Hugofurther/cabane-control/docs/Stations/Optically Isolated MOS FET 4 Channel Controller Board/s-l1600-1.webp

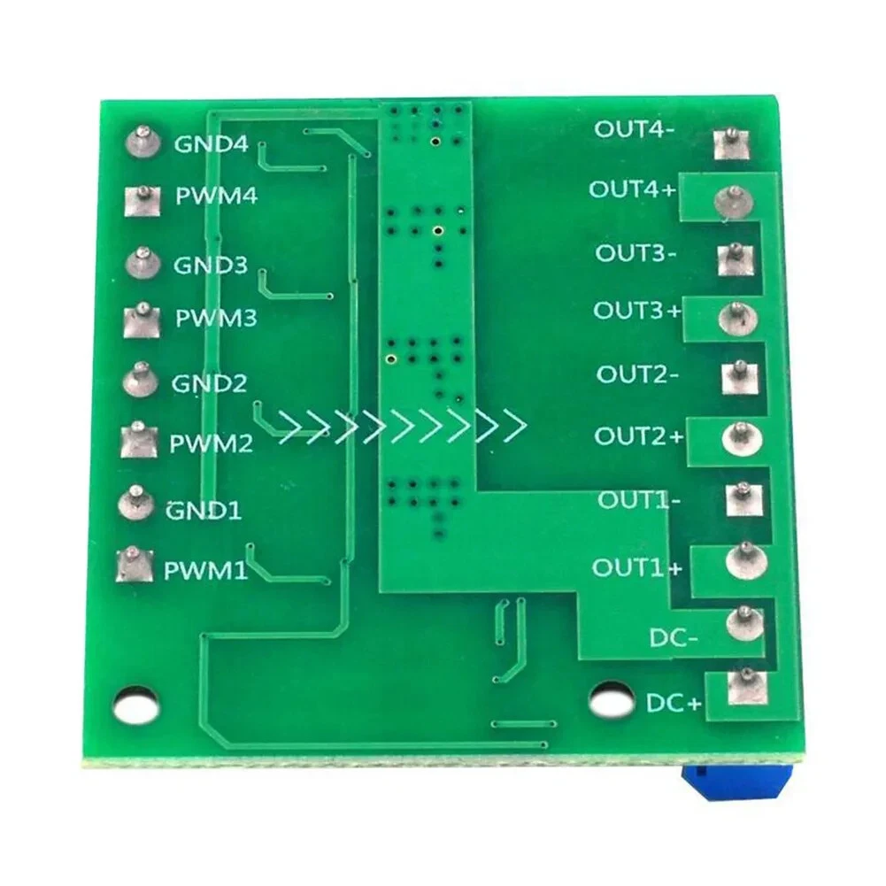
docs/Stations/Optically Isolated MOS FET 4 Channel Controller Board/s-l1600-1.webp
