Hugofurther/cabane-control/docs/Main/ELEC-MEGA2560-PINOUT.webp

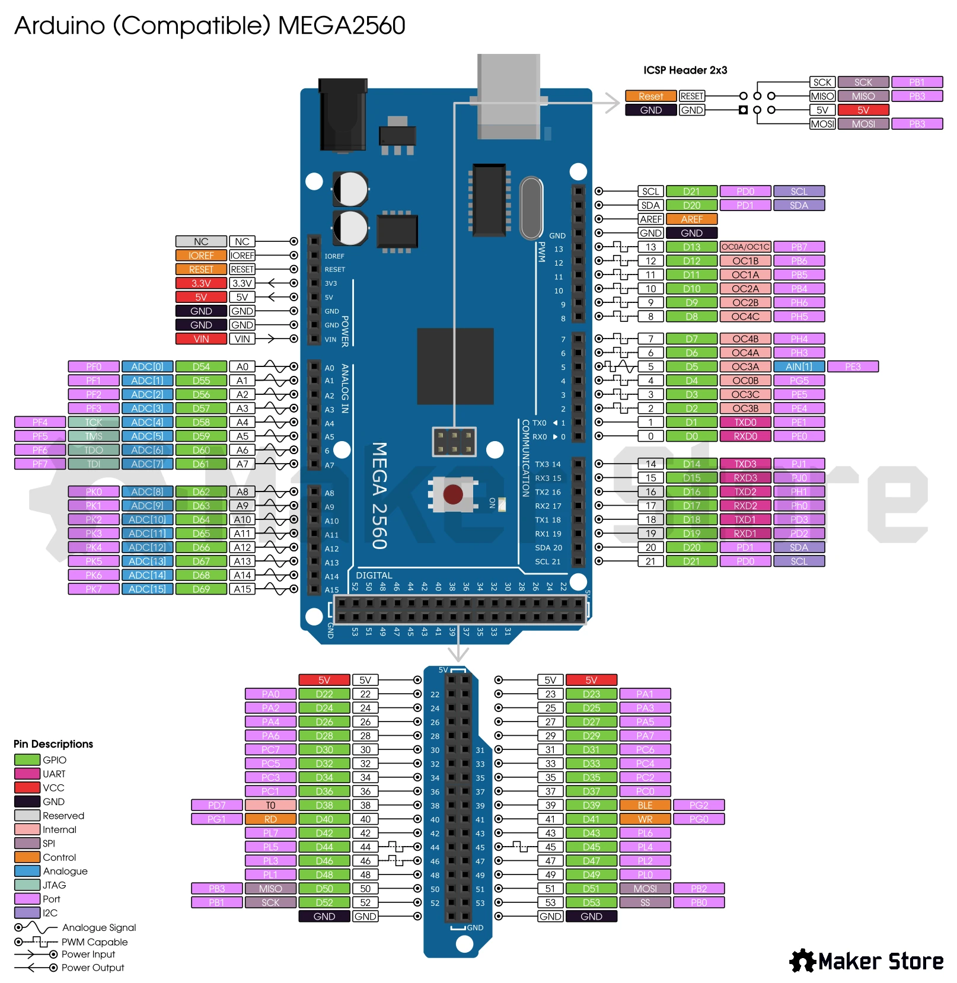
docs/Main/ELEC-MEGA2560-PINOUT.webp
