Hugofurther/cabane-control/docs/Webapp/1. The Architecture Change.md

It is **moderately difficult**, but entirely feasible. Since you already have a working UDP protocol, you have done the hardest part.

Adding a Raspberry Pi Webapp essentially turns the Pi into a "Virtual Operator" that stands next to your Main Controller and presses "Virtual Buttons."

Here is the breakdown of what it would take to implement this architecture:

### 1. The Architecture Change
Currently, your Main Controller is the **Single Source of Truth**. It reads physical pins and sends commands.
To add a Webapp, you cannot have the Pi talk directly to the Stations (this causes "Split Brain" where the Mega says OFF and the Pi says ON).

Instead, the **Pi must talk to the Main Controller**, and the Main Controller must decide which input to obey (Physical Switch vs. Web Command).

### 2. Required Changes to Main Controller (Arduino Mega)
You would need to modify your firmware to accept "Remote Commands."

*   **New Data Structure:** You need a `virtualState[TOTAL_INPUTS]` array alongside your `stableState` (physical) array.
*   **New UDP Handler:** You need to define a new packet type (e.g., `0xB1`) that the Pi sends to the Mega containing the state of the buttons on the web interface.
*   **Logic Merger:** You need to decide how the override works.
    *   *Scenario A (OR Logic):* If Physical Switch OR Web Switch is ON $\to$ Relay ON.
    *   *Scenario B (Priority Logic):* You add a "Master Auto/Manual" switch. If Manual, read physical pins. If Auto, read UDP packets from the Pi.
    *   *Scenario C (Last Latch):* Whichever source changed last (Switch flip or Web click) sets the state.
*   **Feedback Output:** The Mega needs to send a packet back to the Pi regularly (or on change) containing the status of all LEDs/Relays so the Web UI updates in real-time.

### 3. The Raspberry Pi Software Stack
The Pi acts as a bridge between HTTP (Web browser) and UDP (Arduino).

*   **Backend (Python/Node.js):**
    *   Needs a UDP Socket listener to receive status updates from the Mega.
    *   Needs a UDP Sender to fire command packets to the Mega.
    *   Needs a Web Server (Flask, FastAPI, or Express) to serve the webpage to your phone/laptop.
*   **Frontend (HTML/JavaScript):**
    *   A dashboard displaying the 24 switches and LED statuses.
    *   JavaScript to send button clicks to the Backend.
    *   JavaScript to poll the Backend for the latest status (to turn web LEDs red/green).

### 4. The Complexity & Risks
Here is where the difficulty lies:

*   **State Synchronization (The hardest part):**
    If the physical switch is ON, but you turn it OFF via the Web, what happens?
    *   Does the physical switch stop working?
    *   Does the physical LED flash to indicate a mismatch?
    *   You need robust logic to handle "Physical switch says X, Web says Y."
*   **Safety/Watchdog:**
    If you turn a pump ON via Web, and the Pi crashes or Wi-Fi dies, does the pump stay ON forever? You would need a "Network Watchdog" on the Mega to revert to physical switches if the Pi stops sending heartbeats.
*   **Latency:**
    Web $\to$ Pi $\to$ UDP $\to$ Mega $\to$ UDP $\to$ Station $\to$ Relay.
    This adds a few milliseconds of delay, which is usually fine for maple syrup, but the UI must feel responsive.

### Summary
*   **Hardware:** Easy (Pi + Ethernet cable).
*   **Pi Software:** Moderate (Standard Web Server + UDP coding).
*   **Arduino Firmware:** Moderate (Requires rewriting the input logic to accept two sources of input).

**Recommendation:**
If you proceed, implement a **"Remote Mode" physical switch** on the Main Controller.
*   **Switch OFF:** Arduino ignores the Pi. Physical switches rule.
*   **Switch ON:** Arduino ignores physical switches. It only listens to the Pi.

This is the safest and easiest way to code it without creating complex conflict resolution logic.
