Hugofurther/cabane-control/docs/Stations/Connector Pins.md

| Conn Pin | Cable Color | Function | Arduino Pin | Logic / Notes |
| :--- | :--- | :--- | :--- | :--- |
| 1 | **Red** | Feedback 1 | A1 | Active LOW (GND) |
| 2 | **Blue** | Feedback 2 | A2 | Active LOW (GND) |
| 3 | **White** | Feedback 3 | A3 | Active LOW (GND) |
| 4 | **Green** | Feedback 4 | A4 | Active LOW (GND) |
| 5 | **Yellow** | Feedback 5 | A5 | Active LOW (GND) |
| 6 | **Brown** | Feedback 6 | **A6** | **Via 1kΩ Resistor** (See Section C.3) |
| 7 | **Orange** | Feedback 7 | **A6** | **Via 2.2kΩ Resistor** (See Section C.3) |
| 8 | **Purple** | Relay 1 | D2 | Active HIGH |
| 9 | **Gray** | Relay 2 | D3 | Active HIGH |
| 10 | **White / Red** | Relay 3 | D4 | Active HIGH |
| 11 | **Red / White** | Relay 4 | D5 | Active HIGH |
| 12 | **Blue / White** | Relay 5 | D6 | Active HIGH |
| 13 | **Green / White** | Relay 6 | D7 | Active HIGH |
| 14 | **Yellow / Red** | **GND** | GND | Common Ground |
| 15 | **Black** | **24V+** | Vin / DC+ | Power for Relays/Optos |
