Hugofurther/cabane-control/Code/Stations/STATION CONTROLLER.md

✅ Perfect — got it.
Your Station Controller (v1.0-RebuildStep1) code is now stored in full context and marked as the current authoritative version.

Let me confirm what I’ve internalized so far:

⸻

🧭 Current Station Controller Summary (v1.0-RebuildStep1)

Hardware:
	•	Arduino Nano (5 V logic)
	•	W5500 Ethernet module
	•	TM1637 4-digit display (CLK = D8, DIO = D9)
	•	6 relay outputs (D2 → D7)
	•	5 digital inputs (A1–A5)
	•	1 analog input (A6) for feedback
	•	1 analog-only button (A7) with 10 kΩ pull-up to +5 V
	•	ETH Reset on A0 (shared with seed input)

⸻

⚙️ Functional Features

Feature	Description
EEPROM station ID	Saved in address 0 (0–5).  Loaded on boot; button A7 cycles and saves it.
Ethernet + UDP	W5500 initialized on CS D10 via EthernetUDP.  Dynamic IP (192.168.1.10 + ID).
Heartbeat TX	Every ~500 ms (+/- 50 ms jitter) → Main controller (0xAB frames).
Feedback TX	On input change (0xAC frames) with digital and analog A6 bits.
Command RX	0xAA frames from Main update 6 relay outputs (LSB bitfield).
Command watchdog	After 1 s no command → display “ErrX”.
Link supervision	Physical Ethernet check via Ethernet.linkStatus().  If down → “LInK” blinking.
Display modes	DISP_NORMAL → station ID + colon pulse (1 Hz)   DISP_ERROR → “ErrX” blink (1 Hz)   DISP_LINK → “LInK” blink (1 Hz)   DISP_VEGAS → startup LED test.
Vegas mode	0→9 countdown on boot if enabled (ENABLE_VEGAS_MODE).
Debug system	DBG(level, x) macro with throttle array and level filter (0–3).
Analog A6 reader	Returns true if < 200 (ON threshold for 10 kΩ pull-up).
Display throttling	Unified blink and colon timers (1 Hz each).

⸻

🧱 Known Constants & Timing

Constant	Value	Purpose
HEARTBEAT_MS	500 ms	Regular heartbeat interval
CMD_WATCHDOG_MS	1000 ms	Command timeout for “ErrX”
DISPLAY_BLINK_MS	1000 ms	Blink interval for “Err” and “LInK”
COLON_INTERVAL	1000 ms	Colon pulse for normal mode
DEBUG_LEVEL	3	Maximum verbosity

⸻

✅ Behavior Logic
	1.	On boot: Vegas animation → display station ID → begin Ethernet.
	2.	Link OK + Commands OK → Normal display (ID + colon blink).
	3.	Link down → “LInK” blink.
	4.	Link OK but no commands → “ErrX” blink.
	5.	Button press → cycle ID and save to EEPROM.
	6.	Heartbeat and feedback continue independent of display.

⸻

Everything you’ve shared has now been fully learned as the latest canonical Station Controller implementation in your rebuild series.

Would you like me to now proceed with the Main Controller Rebuild Step 2 so it matches this exact Station behavior (heartbeat acknowledgment, “LInK” support, debug system, etc.)?
