Hugofurther/cabane-control/docs/Main/Enclosure Dims.jpg

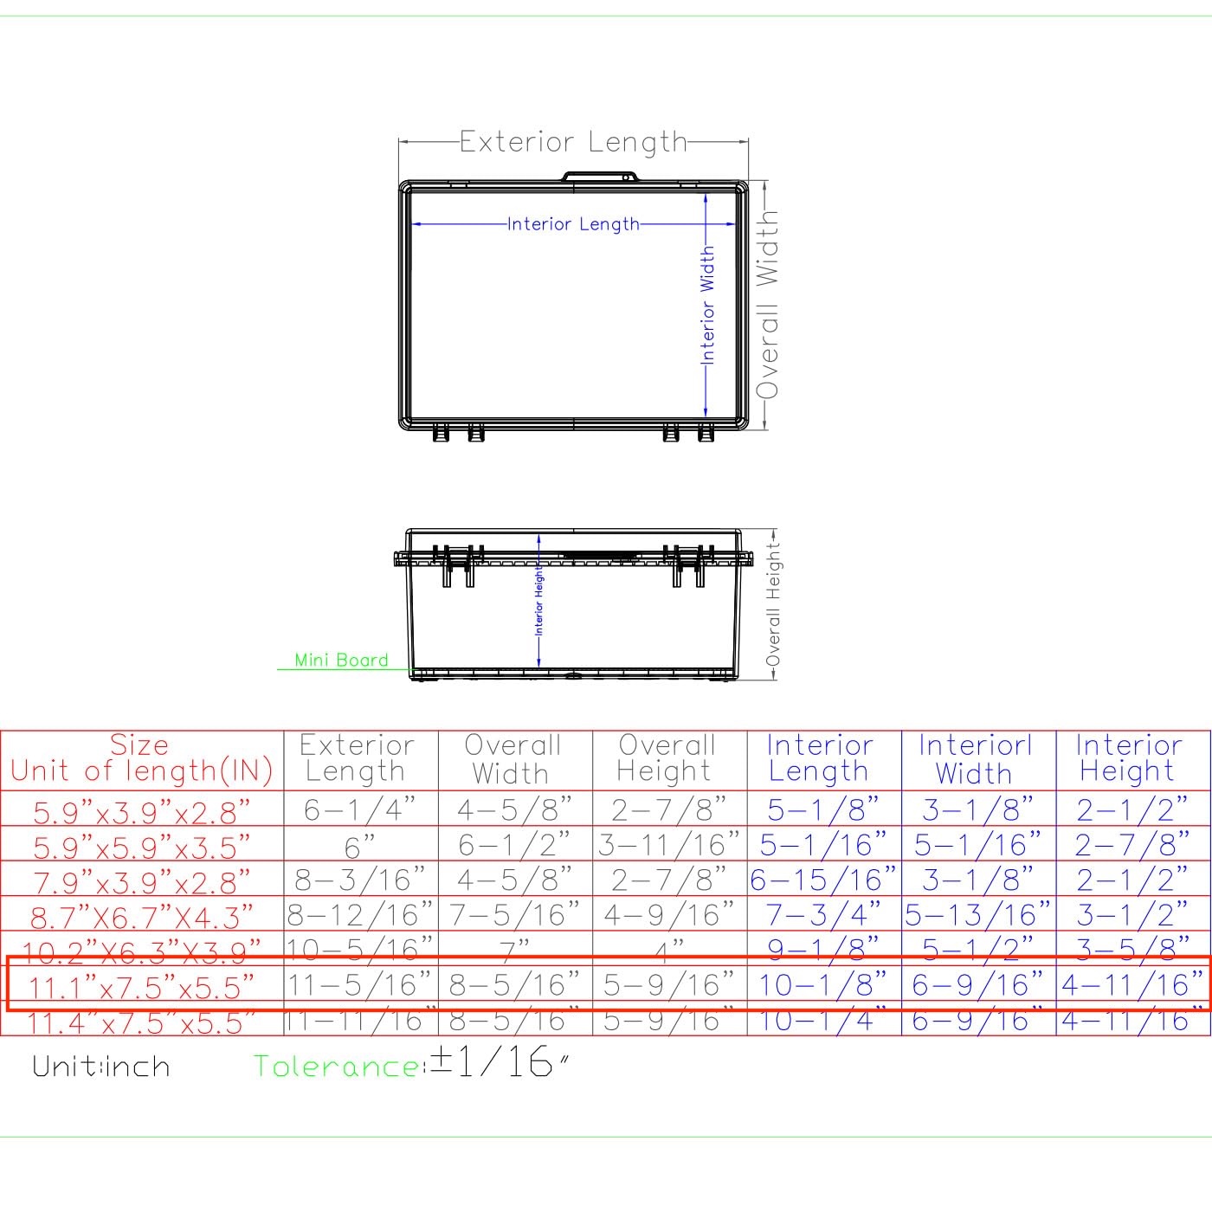
docs/Main/Enclosure Dims.jpg
