Hugofurther/cabane-control/docs/Main/Ethercon.jpg

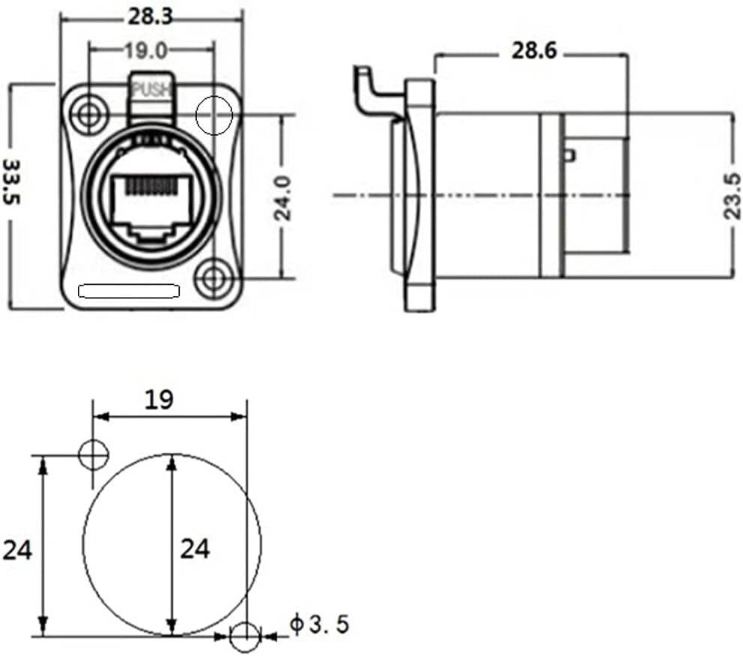
docs/Main/Ethercon.jpg
