Hugofurther/cabane-control/docs/Main/Main Controller V4.png

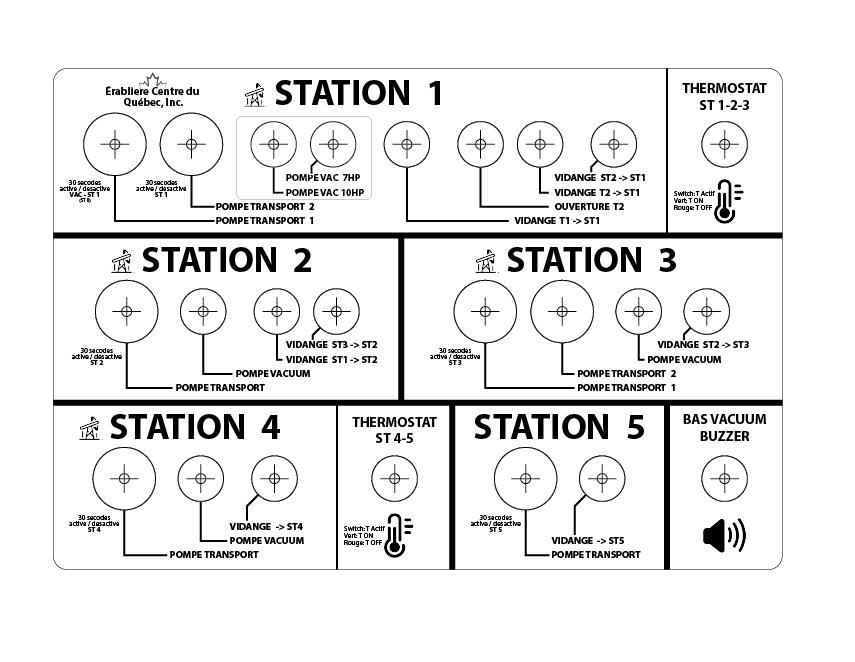
docs/Main/Main Controller V4.png
