Hugofurther/cabane-control/docs/Main/Power Conector.jpg

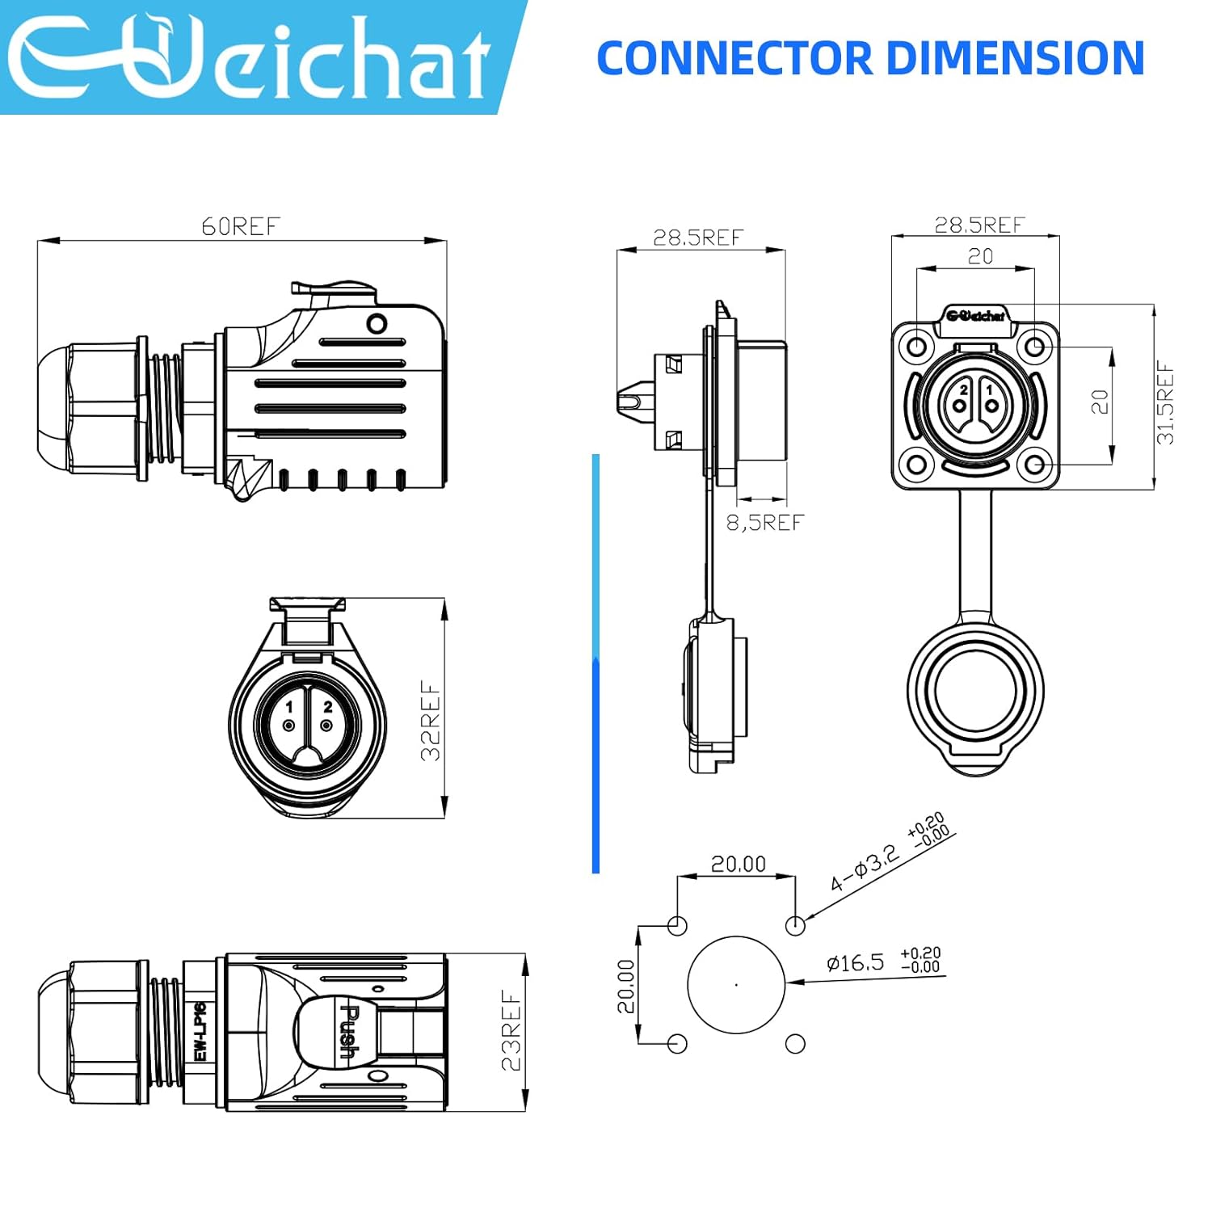
docs/Main/Power Conector.jpg
