Hugofurther/cabane-control/docs/Main/Speaker Connector.jpg

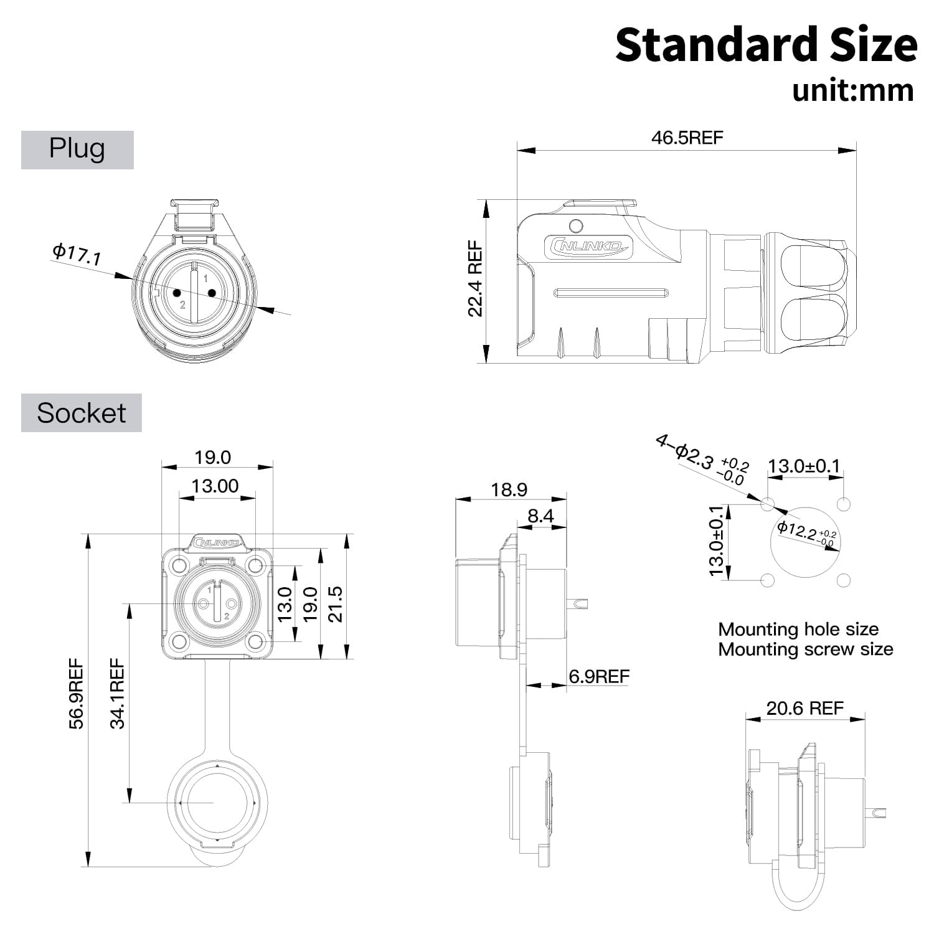
docs/Main/Speaker Connector.jpg
