Hugofurther/cabane-control/docs/MCP-bottom.jpg

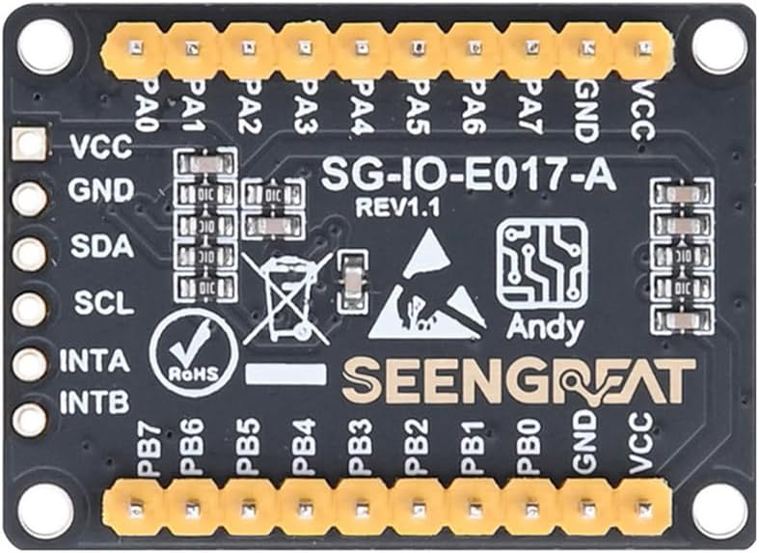
docs/MCP-bottom.jpg
