Hugofurther/cabane-control/docs/MCP-top.jpg

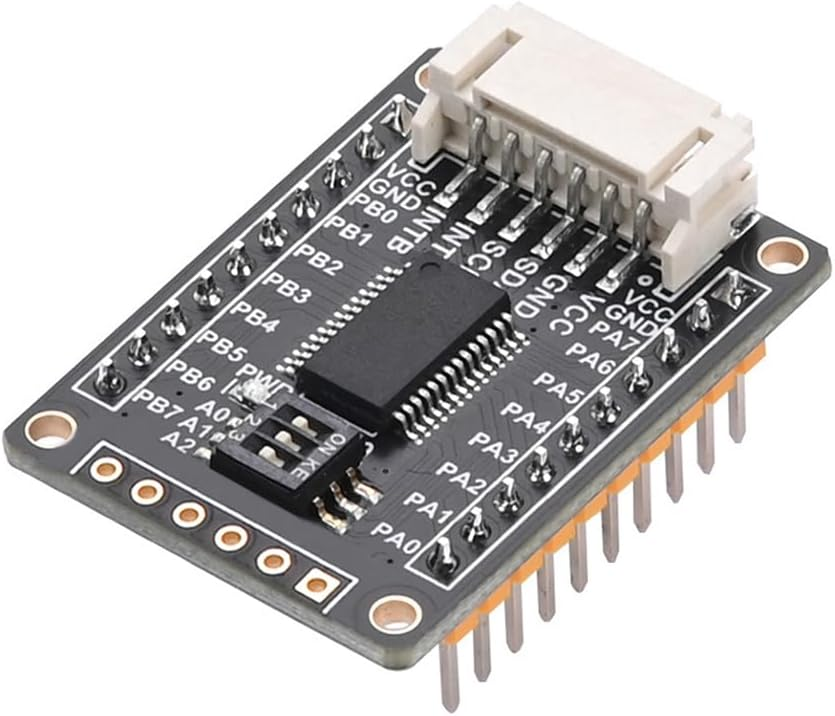
docs/MCP-top.jpg
