Hugofurther/cabane-control/docs/Stations/Enclosure Dims - 2.jpg

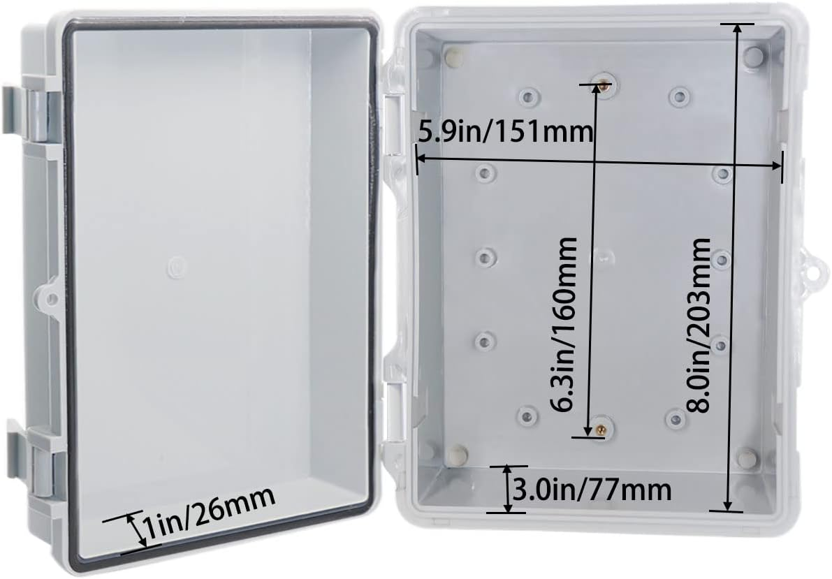
docs/Stations/Enclosure Dims - 2.jpg
