Hugofurther/cabane-control/docs/Stations/Enclosure Dims.jpg

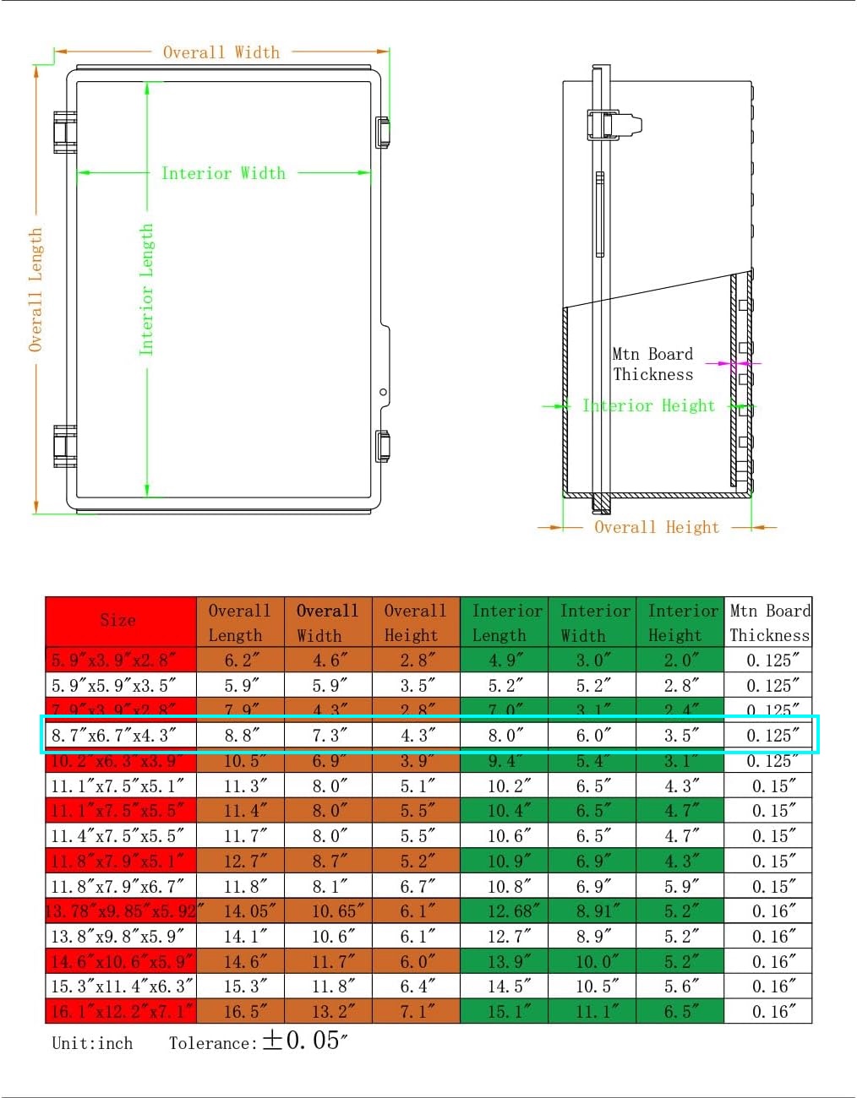
docs/Stations/Enclosure Dims.jpg
