Hugofurther/cabane-control/docs/Stations/HY-M158.jpg

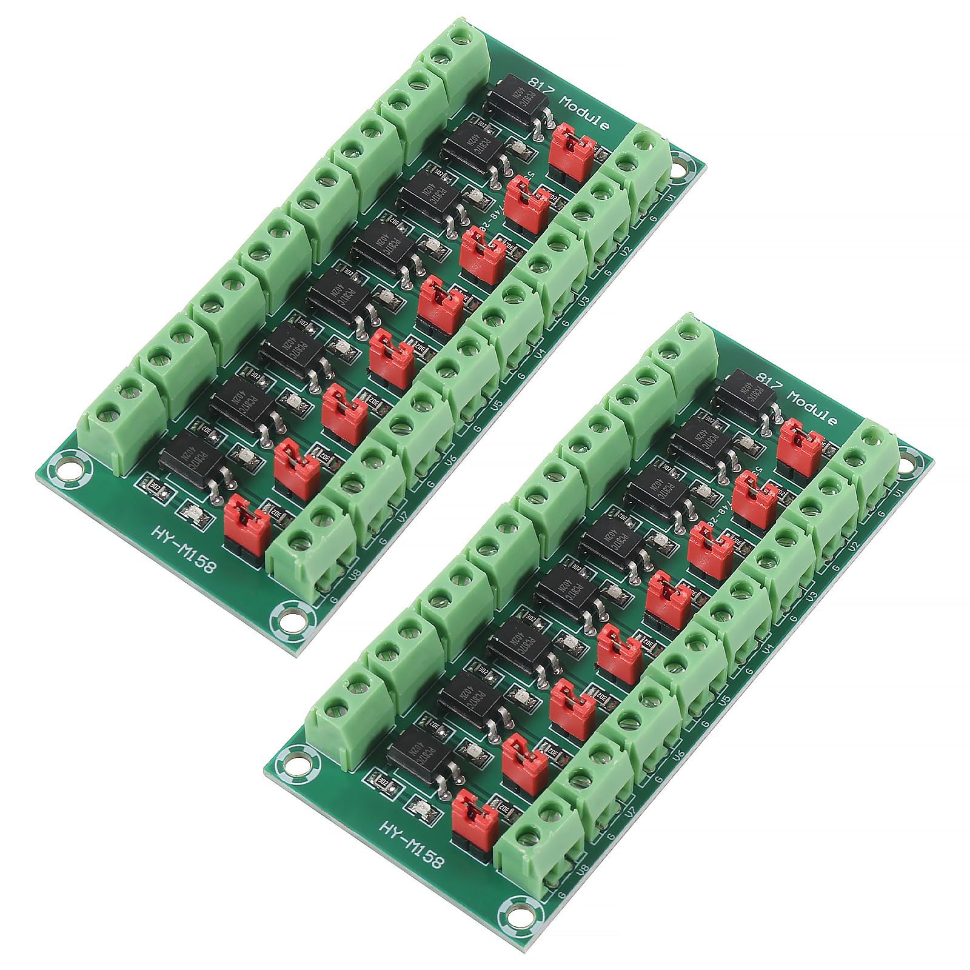
docs/Stations/HY-M158.jpg
