Hugofurther/cabane-control/docs/Stations/PC817-HY-M158-8-Channel-Optocoupler-Photocoupler-Phototransistor-Module-2.jpg

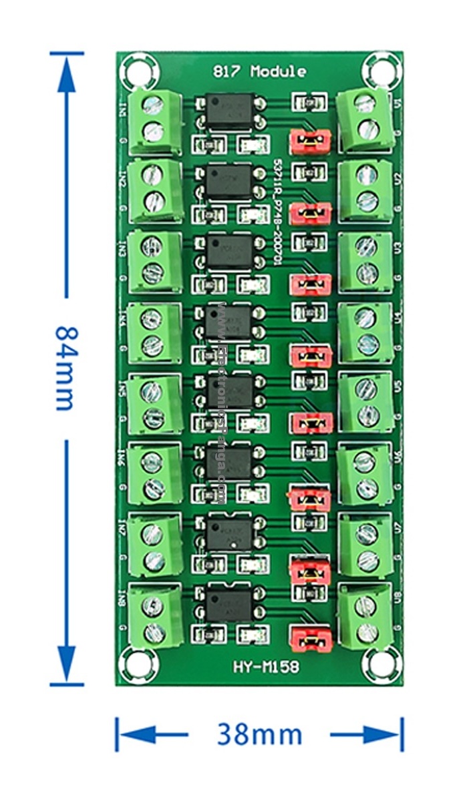
docs/Stations/PC817-HY-M158-8-Channel-Optocoupler-Photocoupler-Phototransistor-Module-2.jpg
