Hugofurther/cabane-control/docs/W5500.jpg

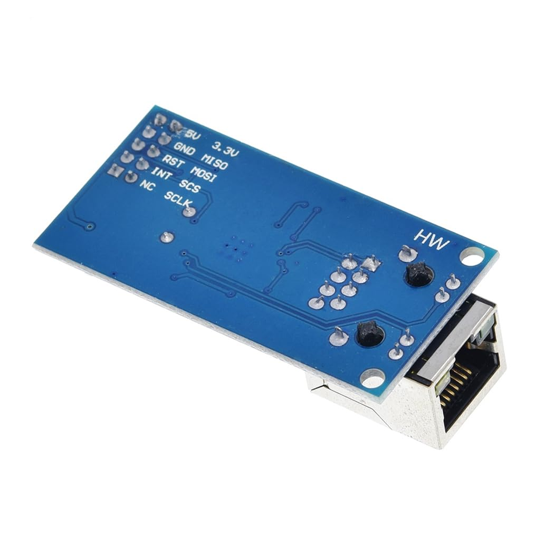
docs/W5500.jpg
