Hugofurther/cabane-control/docs/Stations/Station_Wiring_FR.xlsx

Broche Connecteur | Couleur du câble | Fonction | ST0 | ST1 | ST2 | ST3 | ST4 - ST5 | ST5 | Logique / Notes | Broche Arduino
1 | Rouge | Retour 1 | - | Pompe Transfert 1 | Pompe Transfert | Pompe Transfert 1 | Pompe Transfert | - | Active LOW (GND) | A1
2 | Blue | Retour 2 | - | Pompe Transfert 2 | Vacuum | Pompe Transfert 2 | Vacuum | - | Active LOW (GND) | A2
3 | Blanc | Retour 3 | - | Vacuum | Vid ST1 -> ST2 | Vacuum | Vid ST4 | - | Active LOW (GND) | A3
4 | Vert | Retour 4 | Thermostat | Vid T1 -> ST1 | Vid ST3 -> ST2 | Vid ST2 -> ST3 | Thermostat | - | Active LOW (GND) | A4
5 | Jaune | Retour 5 | Alarme d'Intrusion (Clement) | T2 | - | - | Pompe Transfert | - | Active LOW (GND) | A5
6 | Brun | Retour 6 | - | Vid T2 -> ST1 | - | - | Vid ST5 | - | Via 1kΩ Resistor (See Section C.3) | A6
7 | Orange | Retour 7 | - | Vid ST2 -> ST1 | - | - | - | - | Via 2.2kΩ Resistor (See Section C.3) | A6
8 | Violet | Relay 1 | Vacuum 1 | Pompe Transfert 1 | Pompe Transfert | Pompe Transfert 1 | Pompe Transfert | - | Active HIGH | D2
9 | Gris | Relay 2 | Vacuum 2 | Pompe Transfert 2 | Vacuum | Pompe Transfert 2 | Vacuum | - | Active HIGH | D3
10 | Blanc / Rouge | Relay 3 | - | Vid T1 -> ST1 | Vid ST1 -> ST2 | Vacuum | Vid ST4 | - | Active HIGH | D4
- | Rouge / Blanc | Relay 4 | - | T2 | Vid ST3 -> ST2 | Vid ST2 -> ST3 | - | - | Active HIGH | D5
12 | Blue / Blanc | Relay 5 | - | Vid T2 -> ST1 | Alarme d'Intrusion (Clement) | Alarme d'Intrusion (Clement) | Pompe Transfert | - | Active HIGH | D6
13 | Vert / Blanc | Relay 6 | - | Vid ST2 -> ST1 | - | - | Vid ST5 | - | Active HIGH | D7
14 | Jaune / Rouge | GND | - | - | - | - | - | - | Masse commune | GND
15 | Noir | 24V+ | + | + | + | + | + | + | Alimentation des relais /opto-coupleurs | Vin / DC+
