Hugofurther/cabane-control/docs/Stations/Station Wiring.xlsx

Conn Pin | Cable Color | Function | ST0 | ST1 | ST2 | ST3 | ST4 | ST5 | Logic / Notes | Arduino Pin
1 | Red | Feedback 1 | - | Pompe Transfer 1 | Pompe Transfer | Pompe Transfer 1 | Pompe Transfer | Pompe Transfer | Active LOW (GND) | A1
2 | Blue | Feedback 2 | - | Pompe Transfer 2 | Vacuum | Pompe Transfer 2 | Vacuum | Vid ST5 | Active LOW (GND) | A2
3 | White | Feedback 3 | Thermostat | Vacuum | Vid ST1 -> ST2 | Vacuum | Vid ST4 | - | Active LOW (GND) | A3
4 | Green | Feedback 4 | - | Vid T1 -> ST1 | Vid ST3 -> ST2 | Vid ST2 -> ST3 | - | - | Active LOW (GND) | A4
5 | Yellow | Feedback 5 | Alarme d'Intrusion (Clement) | T2 | - | - | - | - | Active LOW (GND) | A5
6 | Brown | Feedback 6 | - | Vid T2 -> ST1 | - | - | - | - | Via 1kΩ Resistor (See Section C.3) | A6
7 | Orange | Feedback 7 | - | Vid ST2 -> ST1 | - | - | - | - | Via 2.2kΩ Resistor (See Section C.3) | A6
8 | Purple | Relay 1 | Vacuum 1 | Pompe Transfer 1 | Pompe Transfer | Pompe Transfer 1 | Pompe Transfer | Pompe Transfer | Active HIGH | D2
9 | Gray | Relay 2 | Vacuum 2 | Pompe Transfer 2 | Vacuum | Pompe Transfer 2 | Vacuum | Vid ST5 | Active HIGH | D3
10 | White / Red | Relay 3 | - | Vid T1 -> ST1 | Vid ST1 -> ST2 | Vacuum | Vid ST4 | - | Active HIGH | D4
11 | Red / White | Relay 4 | - | T2 | Vid ST3 -> ST2 | Vid ST2 -> ST3 | - | - | Active HIGH | D5
12 | Blue / White | Relay 5 | - | Vid T2 -> ST1 | Alarme d'Intrusion (Clement) | Alarme d'Intrusion (Clement) | - | - | Active HIGH | D6
13 | Green / White | Relay 6 | - | Vid ST2 -> ST1 | - | - | - | - | Active HIGH | D7
14 | Yellow / Red | GND | - | - | - | - | - | - | Common Ground | GND
15 | Black | 24V+ | + | + | + | + | + | + | Power for Relays/Optos | Vin / DC+
