Hugofurther/cabane-control/docs/Main/Main Controller V4 + CUT.pdf

# V4 - 11" x 7.5" x 5.1"

# STATION 1

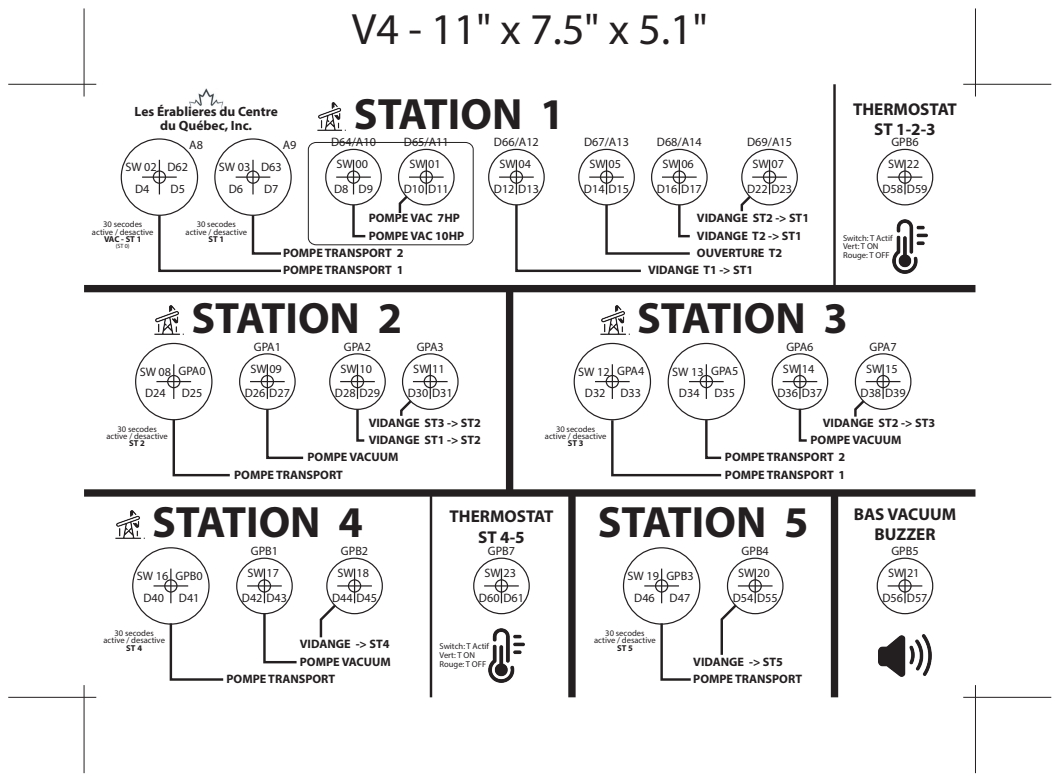
[picture p16: page 1]

Push -> tgl_Pump: 8mm
tgl_Pump -> tgl_Pump: 5mm
Érablieres du Centre
tgl_Pump -> trspt line: 15mm
du Québec
trspt line -> trspt line: 5mm

Les Érablieres du Centre
du Québec, Inc.
