Hugofurther/cabane-control/(commit log)

2025-10-15 Station Changing pins until switching to MEGA
2025-10-16 Reassigned Pins for Arduino Nano Prevent station cycling at startup Add Vegas mode
2025-10-24 Rebuild up to after EEPROM Remaining - Thermostat - Buzzer
    [Main_Phys_switch_pin_test.ino, get_MCP23017_address.ino, test_mcp23017.ino, test_nano_pins.ino]
2025-10-24 Debounce and Thermostat led blink when no link
2025-11-29 Stations Broadcast on 192.168.1.255 all devices
2025-11-29 logic-heavy version of services/logic_engine.js The Input Map: A direct port of your C++ INPUT_MAP so the Pi knows which switch controls which station bit. The Control Loop: A 100ms timer that checks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
2025-12-01 Station Offline Timer implemented.
2025-12-02 Passwrd eye / case insensitive user / user settings
2025-12-03 Added Temperature
2025-12-10 Admin transfer / scroll background / Align switches
2025-12-13 Release buttons titles / background opacity
2025-12-13 Buzzer Sound Arcitecture ( Need testinf )
    [Main_Controller.ino, Station_Controller.ino]
2025-12-19 Automatoins Completed + Shutdown Timer
2025-12-20 Good progress onthe Simulation. Some things left to tighten.
2025-12-26 Before Swtich locig Settings
    [Station Wiring.xlsx, Station_Wiring_FR.xlsx]
2025-12-27 Inverted Logic on Toggle Switches
    [Station_Wiring_FR.xlsx]
2025-12-27 ledPair Logic setting for Inverted
    [Main_Controller.ino]
2025-12-28 Inverted logic fixed
    [Station_Wiring_FR.xlsx]
2025-12-30 Thermostat Inverted Logic fixed
    [Main_Controller.ino]
2025-12-30 Virtual vacuum switch toggle with thermostat
